tuanvyvo-hcmute/DO_NHIET_DO_DUNG_IC_SO/ẢNH_DEMO1.jpg

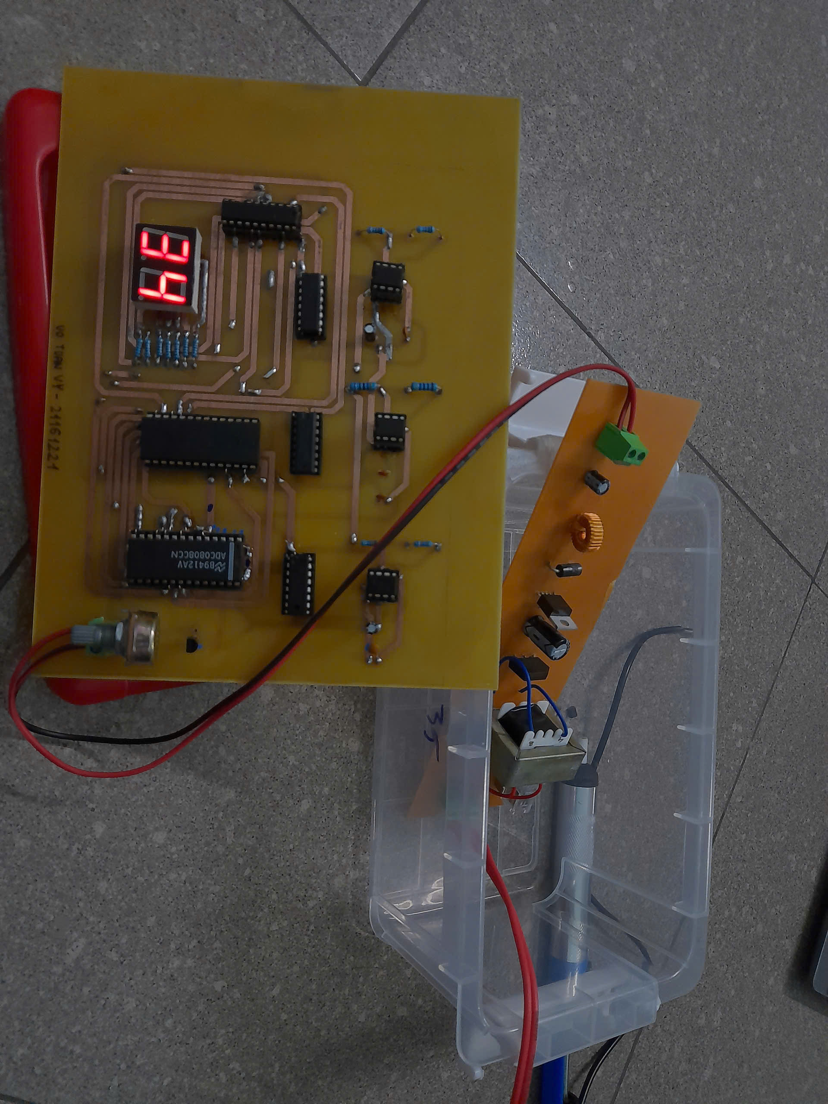
ẢNH_DEMO1.jpg
