tuanvyvo-hcmute/DO_NHIET_DO_DUNG_IC_SO/ẢNH_DEMO2.jpg

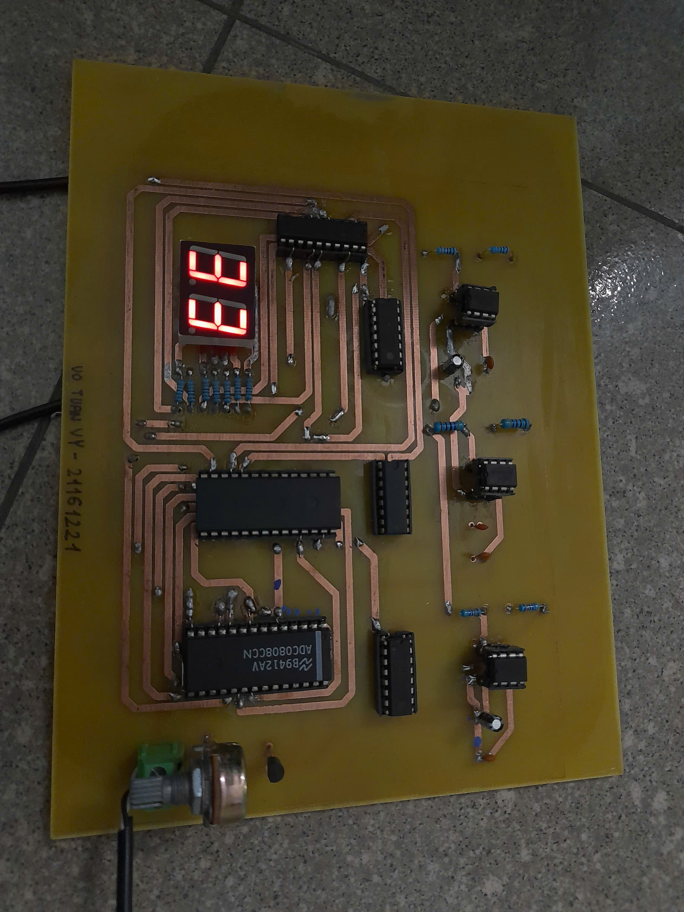
ẢNH_DEMO2.jpg
