tuanvyvo-hcmute/DO_NHIET_DO_DUNG_IC_SO/(list of files, drawings)

Other design files:
MO_PHONG_MACH_CHINH.pdsprj
MO_PHONG_MACH_NGUON.pdsprj
